Almansy612/robot-joint-flange-topology-cnc/cad/flange-topology-optimised.STEP

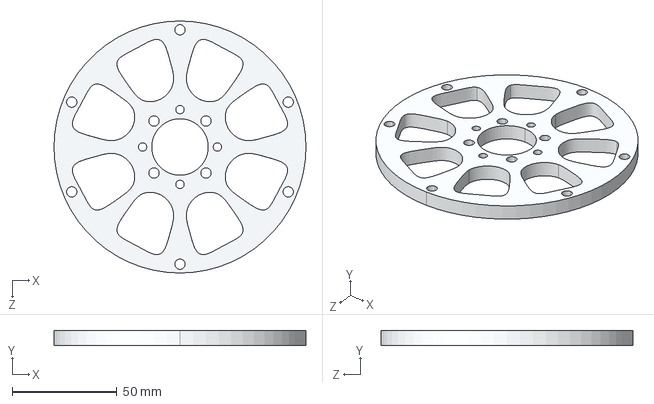
[picture p8: CAD file, 2026-10-19]
cad/flange-topology-optimised.STEP
120.0 x 7.00 x 120.0 mm
