Almansy612/robot-joint-flange-topology-cnc/cad/flange-original.SLDPRT

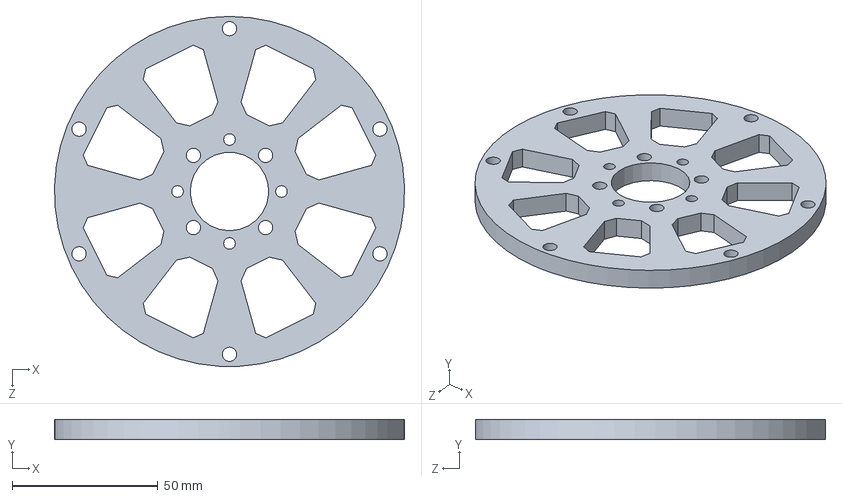
[picture p9: CAD file, 2026-10-19]
cad/flange-original.SLDPRT
119.9 x 7.00 x 120.0 mm
