Almansy612/robot-joint-flange-topology-cnc/(list of files, cad)

Other CAD files:
cad/flange-topology-optimised.SLDPRT
